pkostik/LPG-computer/(commit log)

2023-05-27 Moved to Visual studio code / Platform IO. New feature: - In case we do not receive radio signal for a period of 20 sec. the display power turns off. - On the first radio package received - the displ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
2023-09-17 +Fix red/green square in case of connect/disconnect +L per trip +Show screen with three values: L, L per trip, ADC
    [main.cpp]
